martin2250/ThreePhaseEnergyMonitor/Hardware/esp-carrier.brd

## EAGLE design Hardware/esp-carrier.brd (2019-06-11)

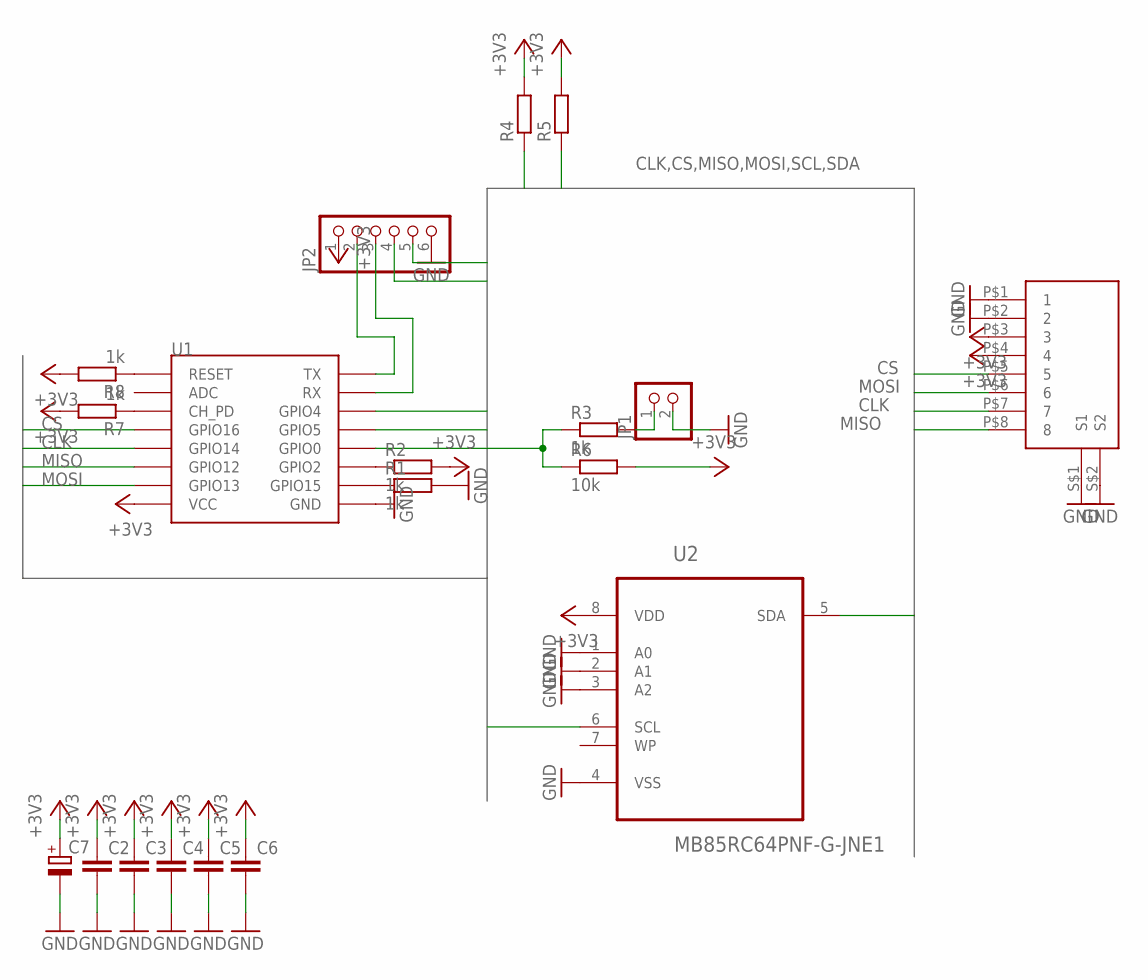
[picture p1: schematic esp-carrier.sch]

Parts:
C1: RJ45-ASSMANN
C2, C3, C4, C5, C6: C-EUC0805; C0805
C7: CPOL-EUF; PANASONIC_F
JP1: PINHD-1X2; 1X02
JP2: PINHD-1X6; 1X06
R1, R2, R3, R7, R8: 1k; R0805
R4, R5: R-EU_R0805; R0805
R6: 10k; R0805
U1: ESP12SMD; ESP12-SMD
U2: MB85RC64PNF-G-JNE1; SOIC127P600X175-8N

Connections:
+3V3: C1.P$3 (3), C1.P$4 (4), C2.1, C3.1, C4.1, C5.1, C6.1, C7.+, JP2.1, R2.2, R4.2, R5.2, R6.2, R7.2, R8.2, U1.VCC, U2.8 (VDD)
CLK: C1.P$7 (7), U1.GPIO14
CS: C1.P$5 (5), U1.GPIO16
GND: C1.P$1 (1), C1.P$2 (2), C1.S$1 (S1), C1.S$2 (S2), C2.2, C3.2, C4.2, C5.2, C6.2, C7.-, JP1.2, JP2.6, R1.2, U1.GND, U2.1 (A0), U2.2 (A1), U2.3 (A2), U2.4 (VSS)
MISO: C1.P$8 (8), U1.GPIO12
MOSI: C1.P$6 (6), U1.GPIO13
unnamed: R1.1, U1.GPIO15
unnamed: R2.1, U1.GPIO2
unnamed: R3.1, R6.1, U1.GPIO0
unnamed: JP1.1, R3.2
unnamed: JP2.2, U1.TXD0 (TX)
unnamed: R7.1, U1.CH_PD
unnamed: JP2.3, U1.RXD0 (RX)
unnamed: R8.1, U1.RESET
SCL: JP2.5, R4.1, U1.GPIO5, U2.6 (SCL)
SDA: JP2.4, R5.1, U1.GPIO4, U2.5 (SDA)

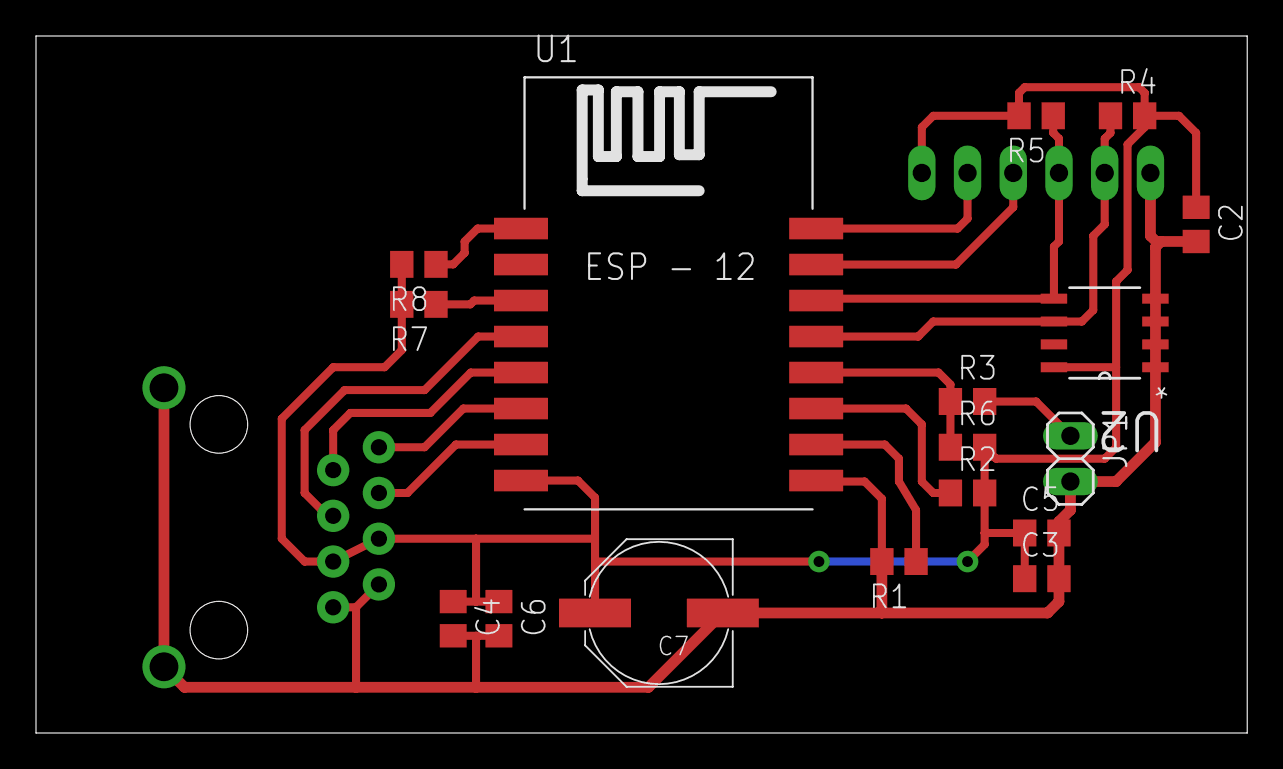
[picture p2: board esp-carrier.brd from above]

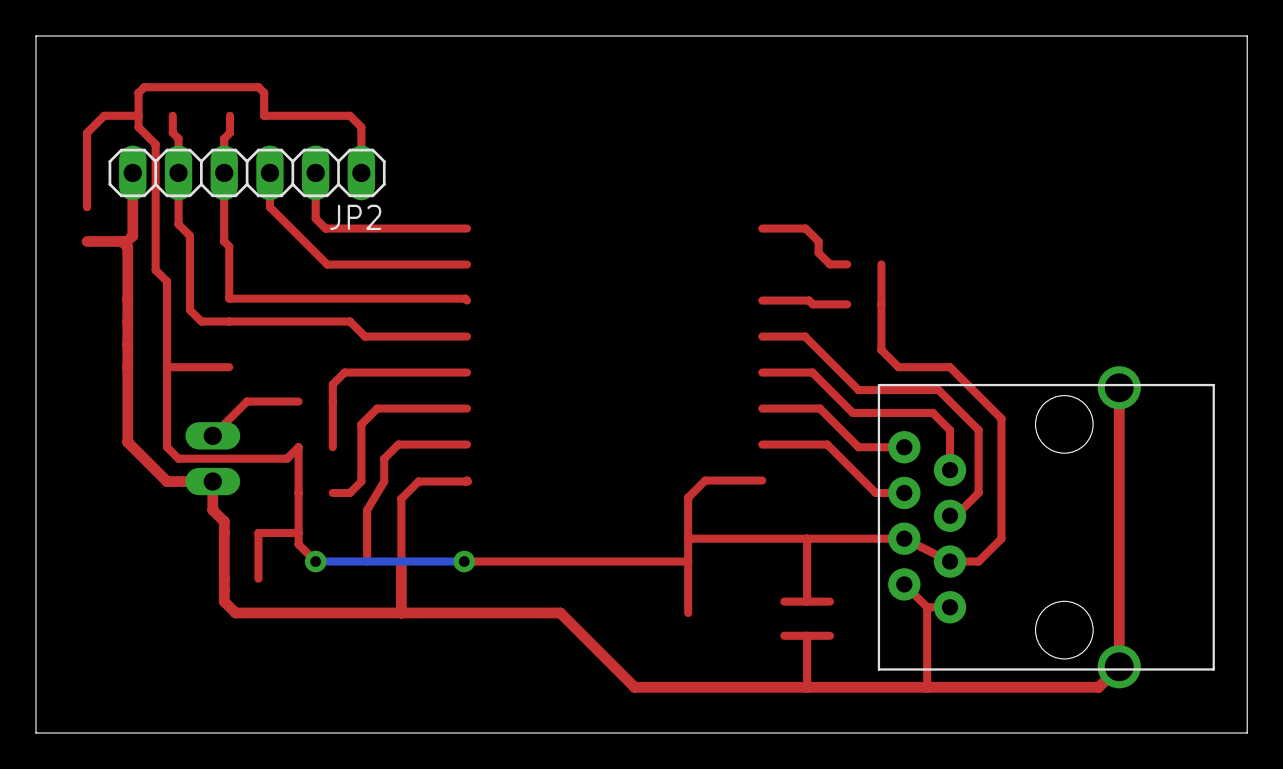
[picture p3: board esp-carrier.brd from below]

Board: 2 copper layers, 67.3 x 38.7 mm, 19 parts (2 on the bottom side), 16 nets.
