martin2250/ThreePhaseEnergyMonitor/Hardware/main.brd

## EAGLE design Hardware/main.brd (2019-06-11)

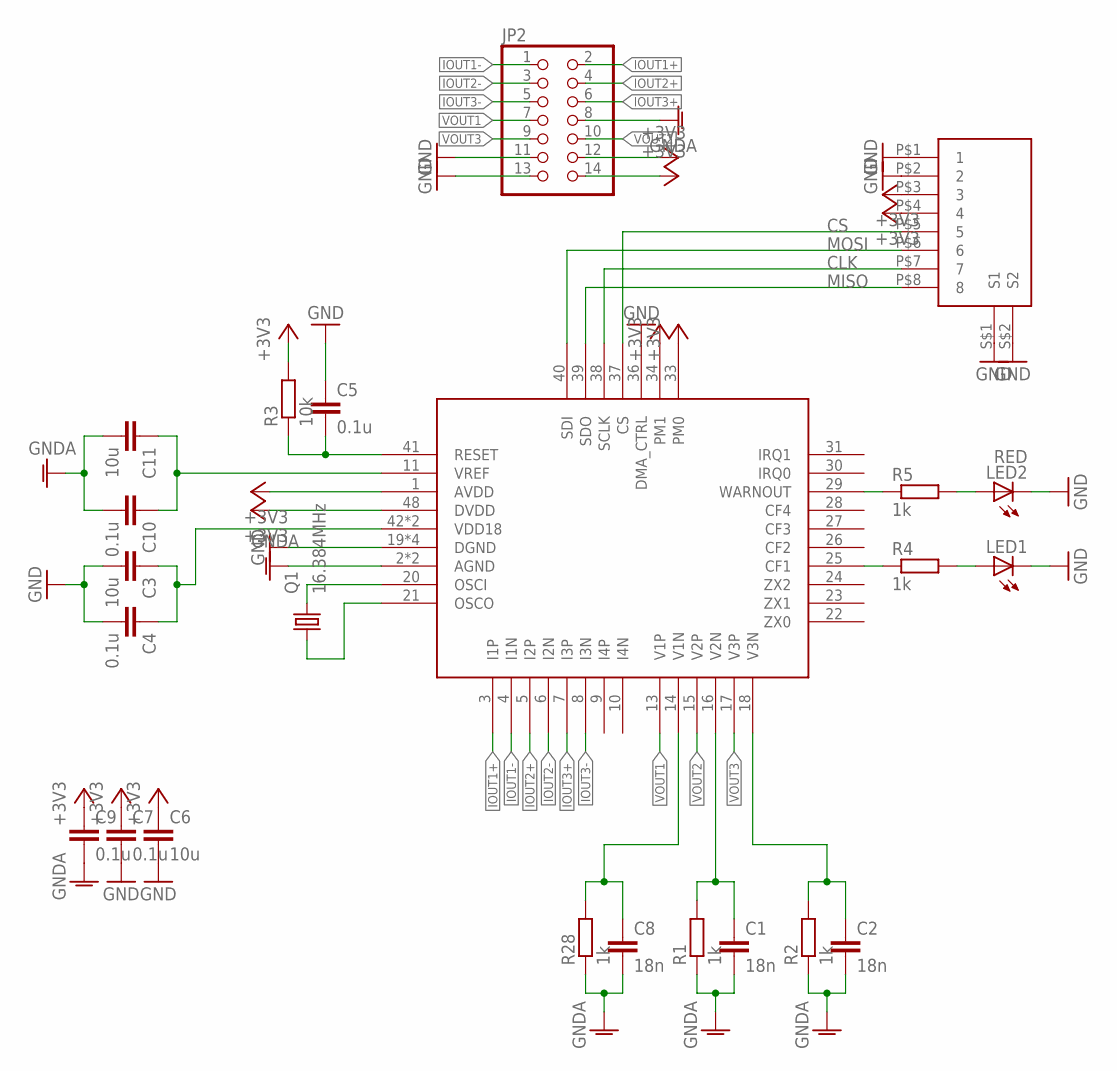
[picture p4: schematic main.sch]

Parts:
C1, C2, C8: 18n; C0805
C3, C6: 10u; C1206
C4, C5, C7, C9, C10: 0.1u; C0805
C11: 10u; C0805
C12: RJ45-ASSMANN
JP2: PINHD-2X7; 2X07
LED1: LEDCHIPLED_1206; CHIPLED_1206
LED2: RED; CHIPLED_1206
Q1: 16.384MHz; 5.0X3.2_KX-9A
R1, R2, R28: 1k; M0805
R3: 10k; M0805
R4, R5: 1k; R0805
U$1: ATM90E36A; QFP50P900X900X120-48

Connections:
+3V3: C6.1, C7.1, C9.1, C12.P$3 (3), C12.P$4 (4), JP2.12, JP2.14, R3.2, U$1.1 (AVDD), U$1.33 (PM0), U$1.34 (PM1), U$1.48 (DVDD)
CLK: C12.P$7 (7), U$1.38 (SCLK)
CS: C12.P$5 (5), U$1.37 (CS)
GND: C3.2, C4.2, C5.1, C6.2, C7.2, C12.P$1 (1), C12.P$2 (2), C12.S$1 (S1), C12.S$2 (S2), JP2.11, JP2.13, LED1.C, LED2.C, U$1.19 (DGND), U$1.32 (DGND), U$1.36 (DMA_CTRL), U$1.44 (DGND), U$1.47 (DGND)
GNDA: C1.2, C2.2, C8.2, C9.2, C10.2, C11.2, JP2.8, R1.1, R2.1, R28.1, U$1.2 (AGND), U$1.12 (AGND)
IOUT1+: JP2.2, U$1.3 (I1P)
IOUT1-: JP2.1, U$1.4 (I1N)
IOUT2+: JP2.4, U$1.5 (I2P)
IOUT2-: JP2.3, U$1.6 (I2N)
IOUT3+: JP2.6, U$1.7 (I3P)
IOUT3-: JP2.5, U$1.8 (I3N)
MISO: C12.P$8 (8), U$1.39 (SDO)
MOSI: C12.P$6 (6), U$1.40 (SDI)
unnamed: Q1.3 (2), U$1.20 (OSCI)
unnamed: Q1.1, U$1.21 (OSCO)
unnamed: C5.2, R3.1, U$1.41 (RESET)
unnamed: C3.1, C4.1, U$1.42 (VDD18), U$1.43 (VDD18)
unnamed: R4.1, U$1.25 (CF1)
unnamed: LED1.A, R4.2
unnamed: R5.1, U$1.29 (WARNOUT)
unnamed: LED2.A, R5.2
VOUT1: JP2.7, U$1.13 (V1P)
VOUT2: JP2.10, U$1.15 (V2P)
VOUT3: JP2.9, U$1.17 (V3P)
VOUT4: C8.1, R28.2, U$1.14 (V1N)
VOUT5: C1.1, R1.2, U$1.16 (V2N)
VOUT6: C2.1, R2.2, U$1.18 (V3N)
VREF: C10.1, C11.1, U$1.11 (VREF)

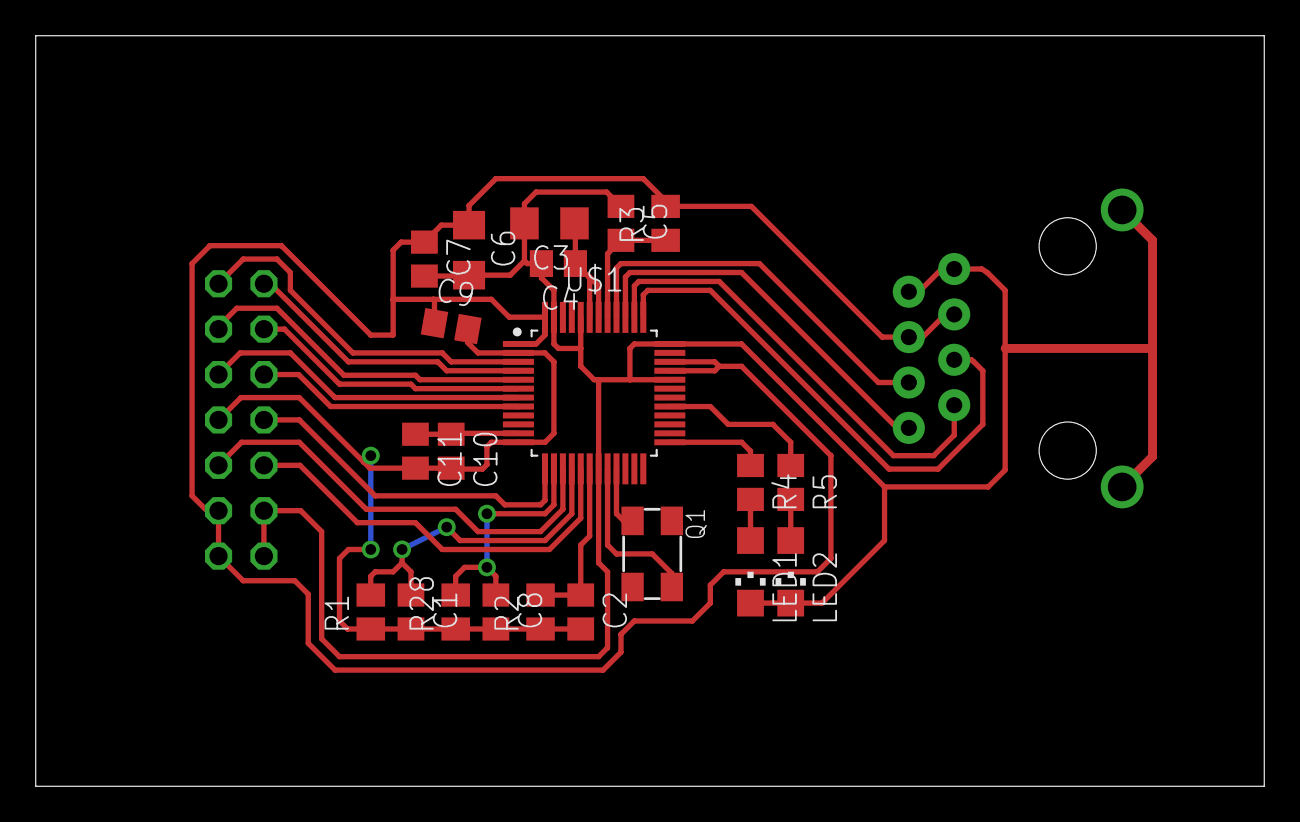
[picture p5: board main.brd from above]

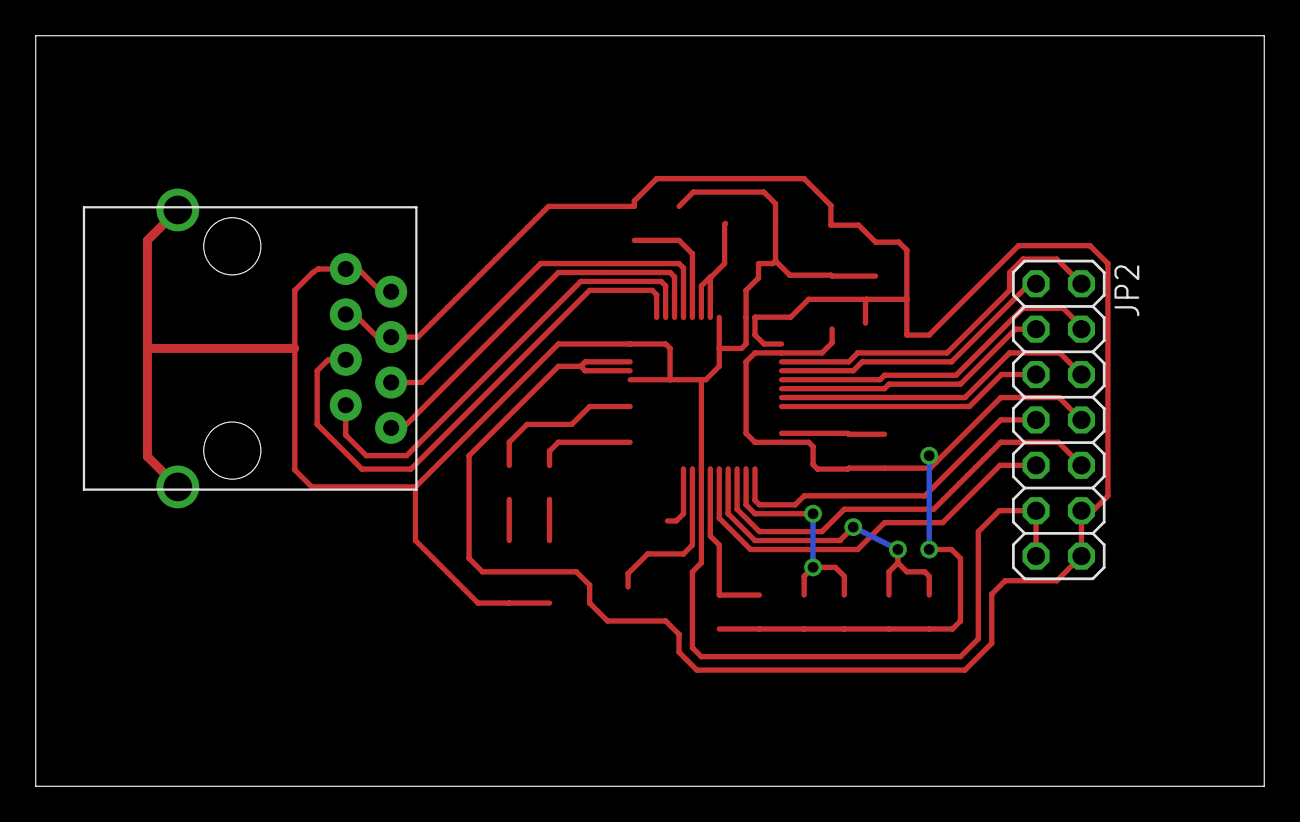
[picture p6: board main.brd from below]

Board: 2 copper layers, 68.8 x 42.0 mm, 23 parts (2 on the bottom side), 28 nets.
