martin2250/ThreePhaseEnergyMonitor/Hardware/input.brd

## EAGLE design Hardware/input.brd (2019-06-11)

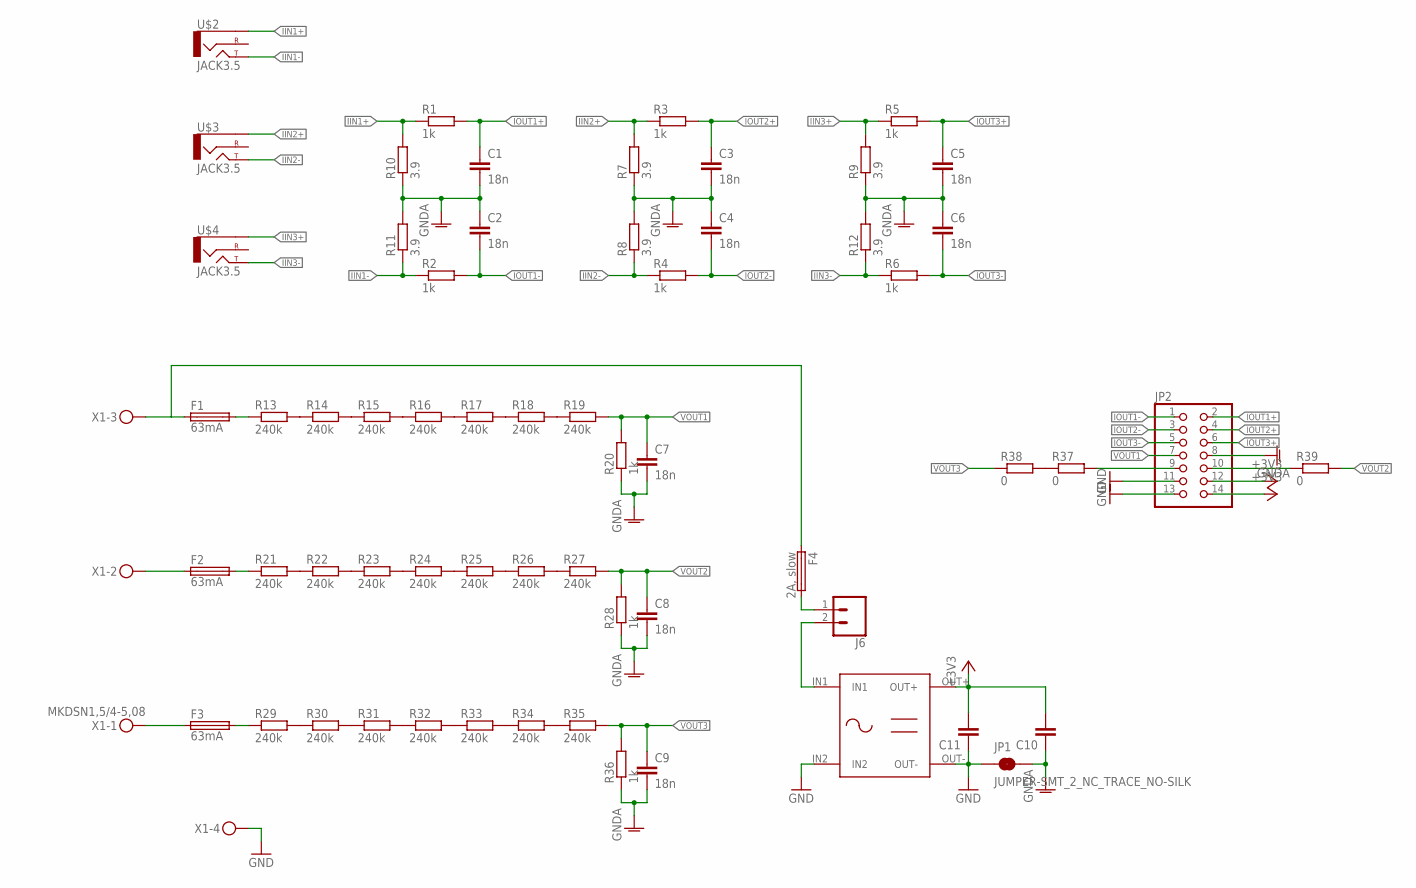
[picture p7: schematic input.sch]

Parts:
C1, C2, C3, C4, C5, C6, C7, C8, C9: 18n; C0805
C10, C11: C-EUC1206; C1206
F1, F2, F3: 63mA; SH25
F4: 2A, slow; SH25
J6: CONN_025MM; SCREWTERMINAL-5MM-2
JP1: JUMPER-SMT_2_NC_TRACE_NO-SILK; SMT-JUMPER_2_NC_TRACE_NO-SILK
JP2: PINHD-2X7; 2X07
R1, R2, R3, R4, R5, R6, R20, R28, R36: 1k; M0805
R7, R8, R9, R10, R11, R12: 3.9; M0805
R13, R14, R15, R16, R17, R18, R19, R21, R22, R23, R24, R25, R26, R27, R29, R30, R31, R32, R33, R34, R35: 240k; R1206
R37, R38, R39: 0; R1206
U$1: MW-IRM; MW-IRM-DIP
U$2, U$3, U$4: JACK3.5; AUDIO-JACK
X1: MKDSN1,5/4-5,08

Connections:
+3V3: C10.2, C11.2, JP2.12, JP2.14, U$1.OUT+
GND: C11.1, JP1.1, JP2.11, JP2.13, U$1.IN2, U$1.OUT-, X1.4
GNDA: C1.2, C2.1, C3.2, C4.1, C5.2, C6.1, C7.2, C8.2, C9.2, C10.1, JP1.2, JP2.8, R7.1, R8.2, R9.1, R10.1, R11.2, R12.2, R20.1, R28.1, R36.1
IIN1+: R1.1, R10.2, U$2.SLEEVE
IIN1-: R2.1, R11.1, U$2.TIP
IIN2+: R3.1, R7.2, U$3.SLEEVE
IIN2-: R4.1, R8.1, U$3.TIP
IIN3+: R5.1, R9.2, U$4.SLEEVE
IIN3-: R6.1, R12.1, U$4.TIP
IOUT1+: C1.1, JP2.2, R1.2
IOUT1-: C2.2, JP2.1, R2.2
IOUT2+: C3.1, JP2.4, R3.2
IOUT2-: C4.2, JP2.3, R4.2
IOUT3+: C5.1, JP2.6, R5.2
IOUT3-: C6.2, JP2.5, R6.2
unnamed: R13.2, R14.1
unnamed: R14.2, R15.1
unnamed: R15.2, R16.1
unnamed: R16.2, R17.1
unnamed: R17.2, R18.1
unnamed: R18.2, R19.1
unnamed: F1.1, F4.1, X1.3
unnamed: F4.2, J6.1
unnamed: F3.2, R29.1
unnamed: R21.2, R22.1
unnamed: R22.2, R23.1
unnamed: R23.2, R24.1
unnamed: R25.2, R26.1
unnamed: R26.2, R27.1
unnamed: R24.2, R25.1
unnamed: J6.2, U$1.IN1
unnamed: R29.2, R30.1
unnamed: R30.2, R31.1
unnamed: R31.2, R32.1
unnamed: R33.2, R34.1
unnamed: R34.2, R35.1
unnamed: R32.2, R33.1
unnamed: R37.1, R38.2
unnamed: F1.2, R13.1
unnamed: F2.1, X1.2
unnamed: JP2.10, R39.1
unnamed: F2.2, R21.1
unnamed: JP2.9, R37.2
unnamed: F3.1, X1.1
VOUT1: C7.1, JP2.7, R19.2, R20.2
VOUT2: C8.1, R27.2, R28.2, R39.2
VOUT3: C9.1, R35.2, R36.2, R38.1

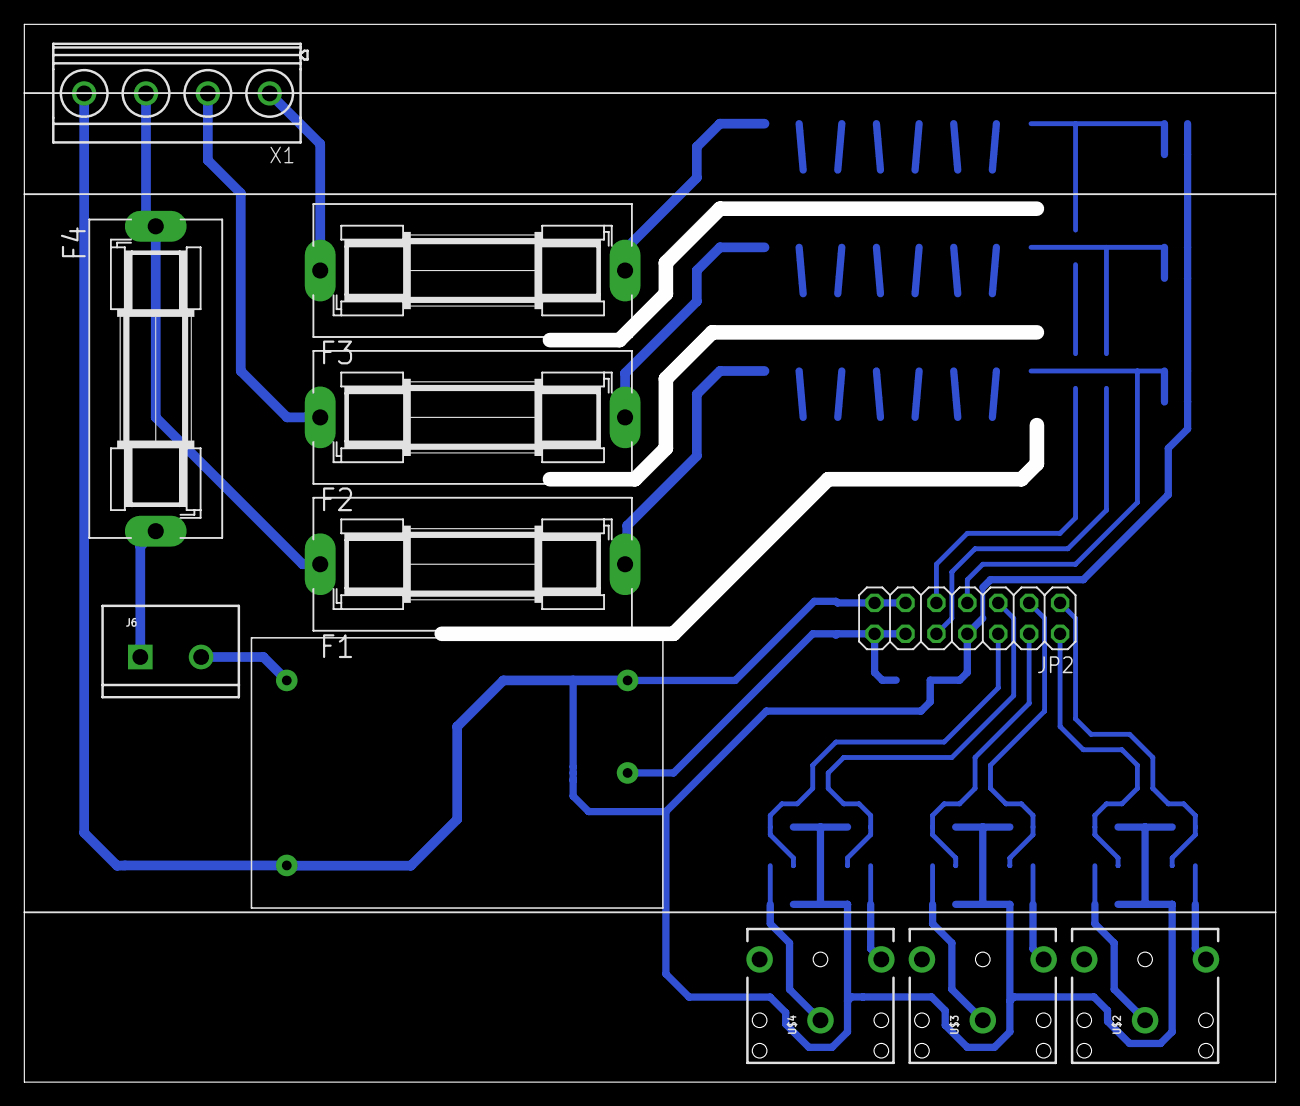
[picture p8: board input.brd from above]

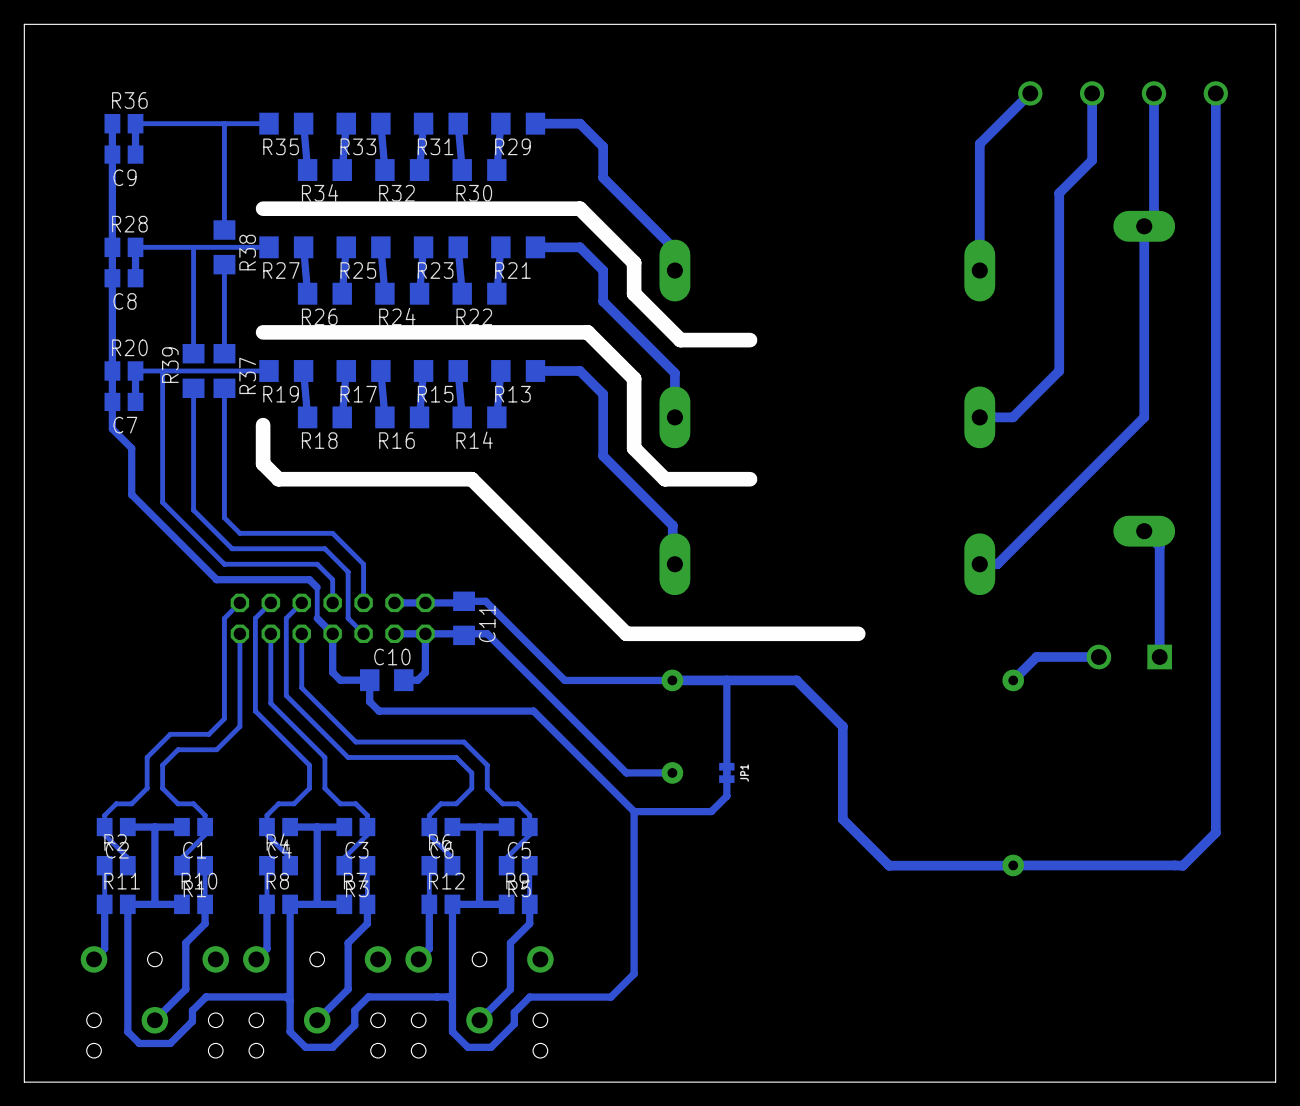
[picture p9: board input.brd from below]

Board: 2 copper layers, 102.8 x 86.9 mm, 62 parts (51 on the bottom side), 47 nets.
